rubenshubnerjunior/VFO_SI5351_Nano_4X/README.md

### Este projeto visa:
#### Construir um gerador de frequência em quadratura ( 0º e 90° ) na faixa de 500 Khz a 30 Mhz.
#### Construir um circuito QSD para demodular sinais de RF modulados em AM, FM e SSB.
#### Construir um circuito QSE para modular um sinal de RF ( em pesquisa...).
#### Diagrama simplificado:
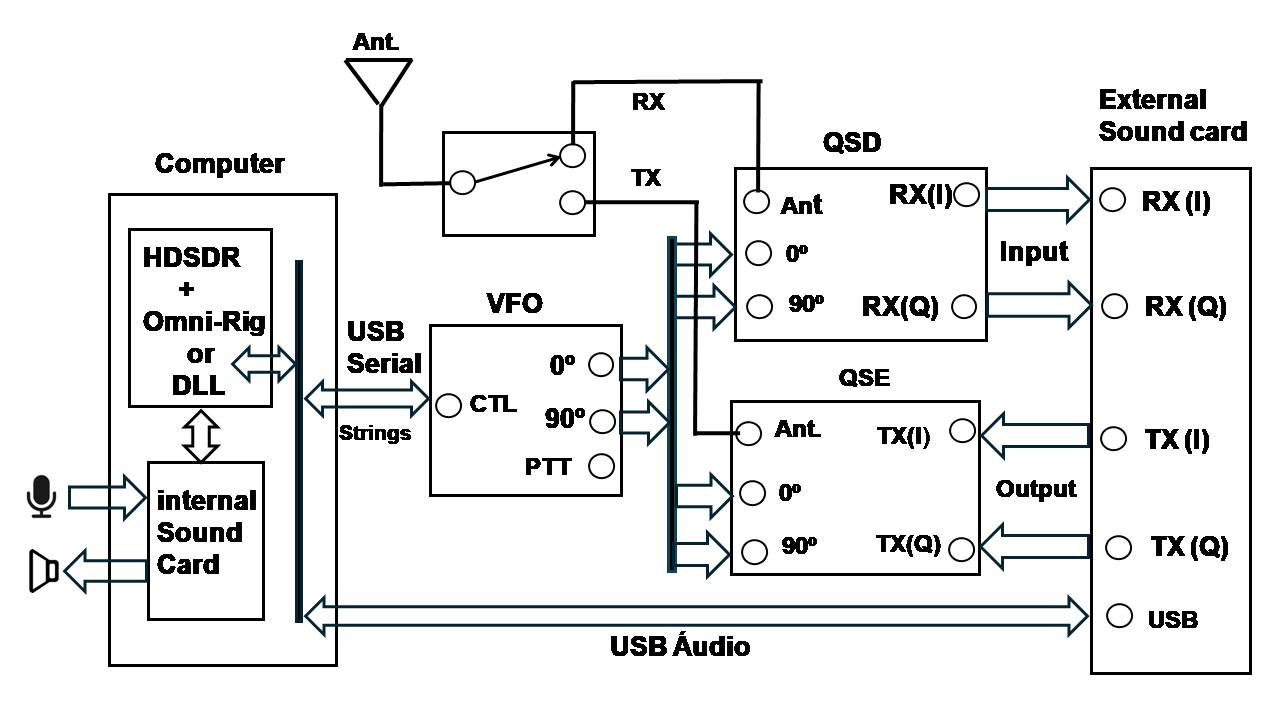
[picture p1: Diagramas/diagrama2.jpg]
- 
#### O Hardware VFO fornece sinais em quadratura na frequência de recepção/transmissão desejada (controlado por um arduino nano).
#### O Hardware QSD recebe o RF da antena e converte em sinais I & Q que vão para o computador através da placa de som.
#### O Hardware QSE recebe os sinais I & Q do computador através da placa de som converte para RF e envia para a antena.
#### Os sinais I & Q estão dentro da faixa da placa de som ( normalmente 48 Khz mas placas de 192 Khz são melhores ).
#### QSD--> Quadrature Signal Decoder.
#### QSE--> Quadrature signal Encoder.
#### No final de cada etapa ( VFO, QSD e futuramente o QSE )  tem  vídeos de teste.
# VFO
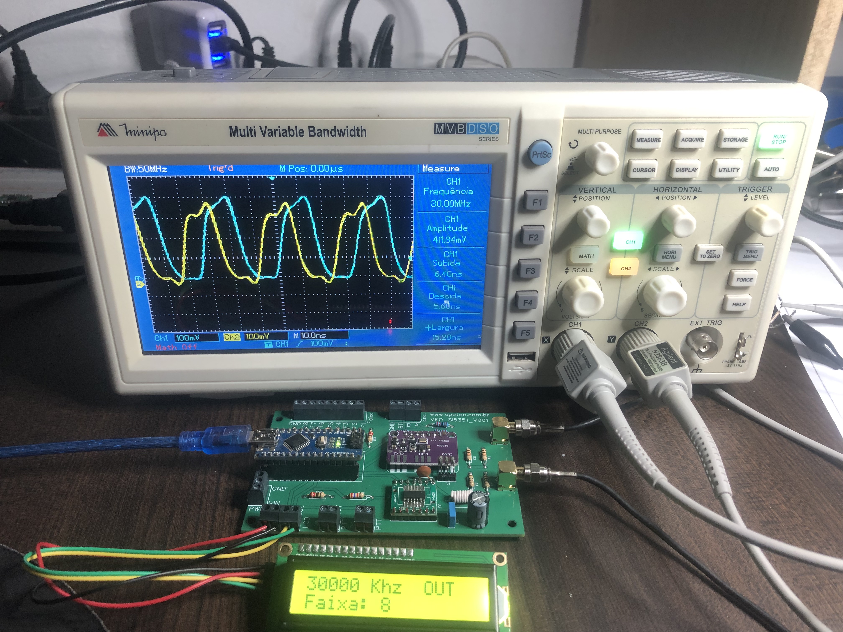
[picture p2: Fotos/VFO_5351_4X.jpg]
- 
#### Basicamente temos o módulo SI 5351 que é comandado através do Arduino Nano usando o protocolo I2C.
#### A saída do módulo SI 5351 deve estar em uma frequência de 4 vezes a frequência desejada para que o divisor por 4 feito pelo flip flop 74AC74 gere a quadratura.
#### O software HDSDR junto com o Omni-Rig usando a configuração TS-480 controla a frequencia e o PTT deste VFO.
#### Foi codificado em python um programa testeVFO.exe para testar o programa do arduino e está na pasta testeVFO o script e o executável.
#### O arquivo testeVFO.exe envia pela porta serial as Strings semelhante as geradas pelo HDSDR.
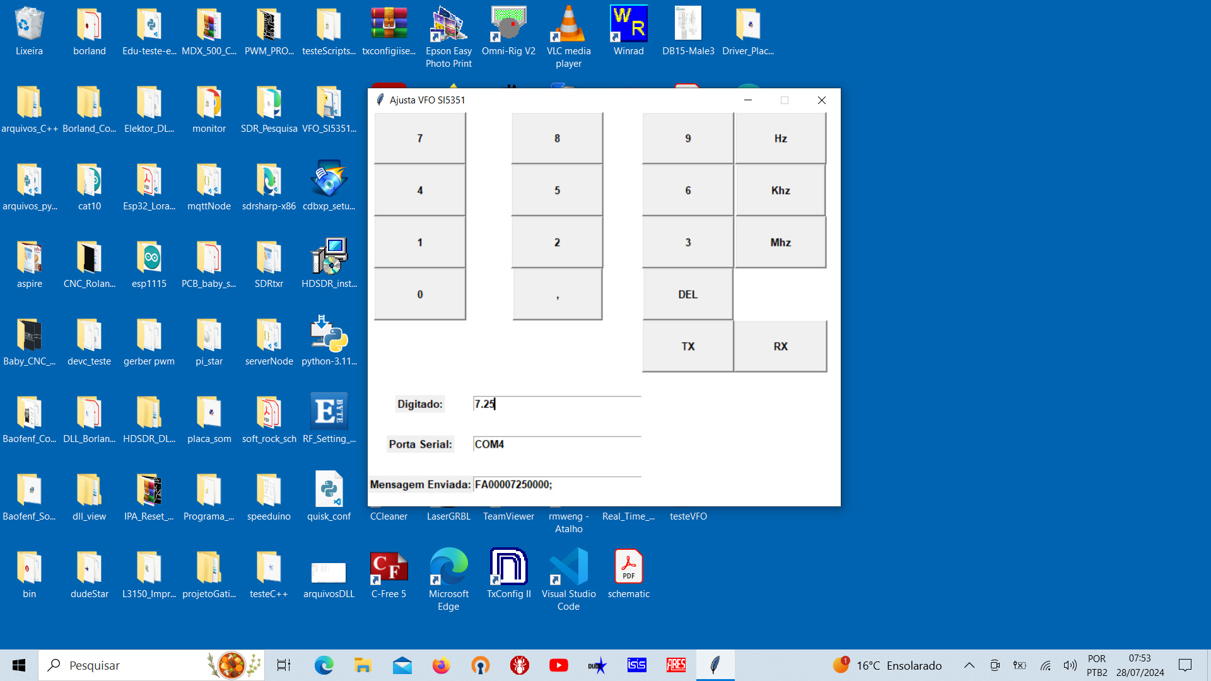
[picture p3: Fotos/testeVFO.jpg]
- 
#### O Arduino nano recebe os comandos através da porta serial (Terminal Serial ou do HDSDR/Omni-Rig) veja abaixo:
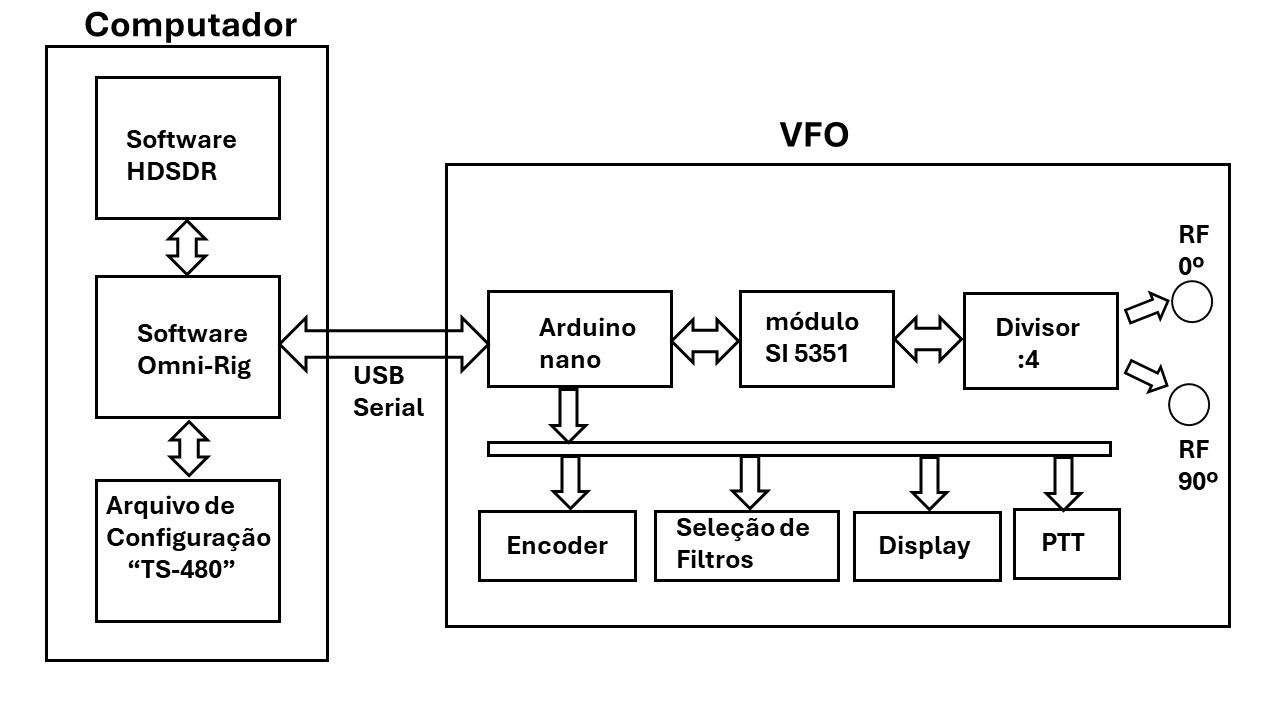
[picture p4: Diagramas/diagrama_vfo.jpg]
- 
#### A Frequência (3 - 30 Mhz) e o Step ( 1Khz, 10Khz, 100Khz e 1000Khz) também pode ser ajustada através do Encoder em KHZ.
#### O PTT também pode ser acionado via contato diretamente na placa.
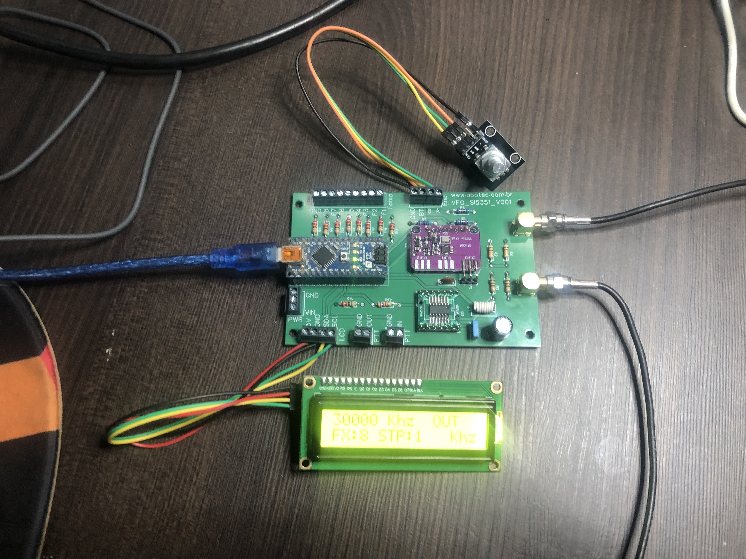
[picture p5: Fotos/VFO_Encoder.jpg]
- 
#### A faixa de 3 a 30 Mhz pode ser dividida em 08 subfaixas e coloca em nivel HI ou Low as saidas do conector para usar nas comutações dos filtros (vide esquema).
#### O display mostra a frequência de saída bem como a faixa e o Step ajustado.
#### O código fonte do arduino (pasta cat11) está bem comentado (CAT= Computer Aided Transceiver ou Computer Aided Tuning).
#### Durante o processo de programação para fazer o Debug foi utilizado outro arduino Nano como escravo I2C pois a porta serial do arduino usado no VFO fica ocupada recebendo e enviando dados para o computador:
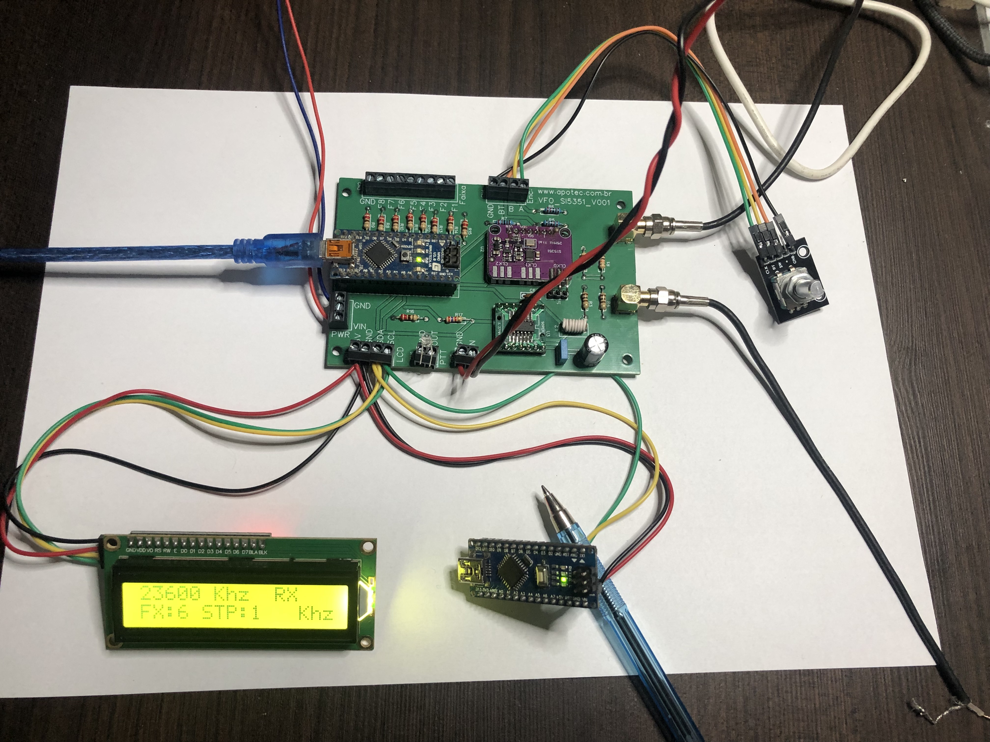
[picture p6: Fotos/nano_debug.jpg]
-  
#### Foi usado o codigo monitor_I2C em outro Arduino Nano Escravo para fazer o Debug pela porta serial (I2C -> Serial), acrescidas linhas de codigo no arduino do cat11.ino para enviar mensagens ao escravo isto somente para Debug depois as linhas foram comentadas e o arduino Nano escravo retirado do circuito.

#### Alguns comandos enviados e recebidos via porta Serial:
- FA00006000000; // HDSDR ajusta o VFO para 6 Mhz
- FA00030000000;  // HDSDR ajusta o VFO para 30 Mhz
- TX1;  // HDSDR envia informação para entrar no modo TX
- RX;   // HDSDR  envia informação para entrar no modo RX
- FA;   // HDSDR pede informação da frequência para o VFO
- FA00007349999; // VFO informa a frequencia para o HDSDR
#### Os comandos do HDSDR para o VFO e do VFO para o HDSDR sempre tem o (;) no final
#### O HDSDR pede várias informações ao VFO e não implementei todas por isto fica a mensagem de Rig não responde.
####  Tela de Configuração do Omni-Rig (A porta do Arduino Nano pode ser localizada no Gerenciador de Dispositivos):
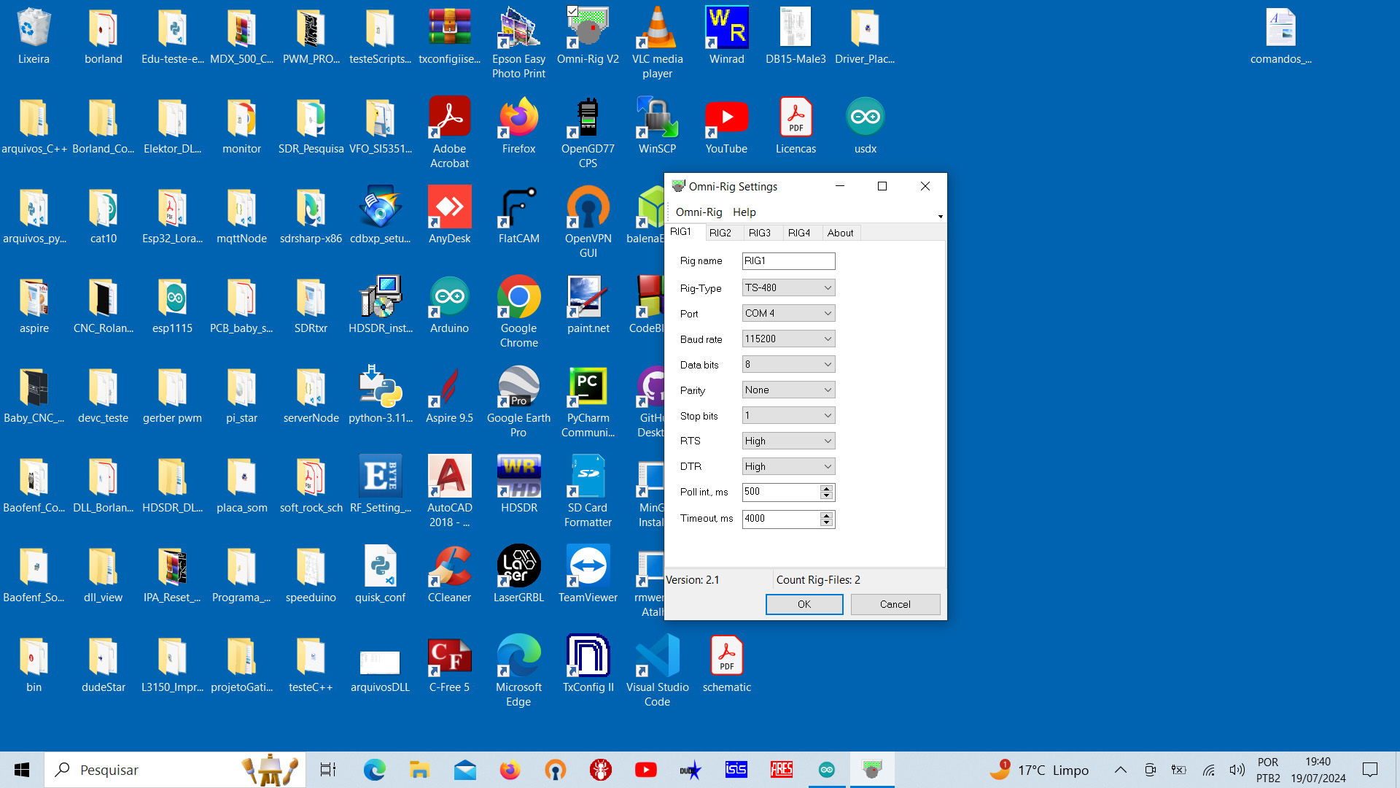
[picture p7: Fotos/Omnia_Config.jpg]
- 
#### No HDSDR no menu Options:
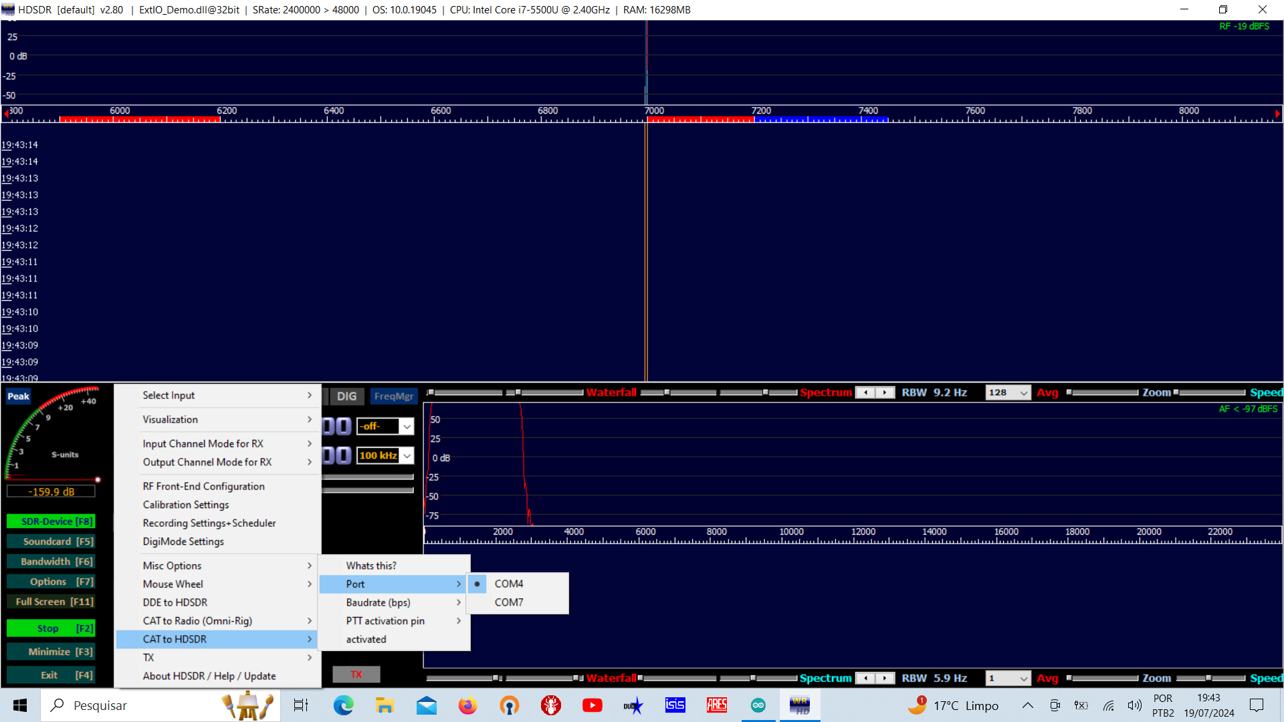
[picture p8: Fotos/HDSDR_01.jpg]
- 
  #### Não esquecer de ativar.
  #### No HDSDR no menu Options:
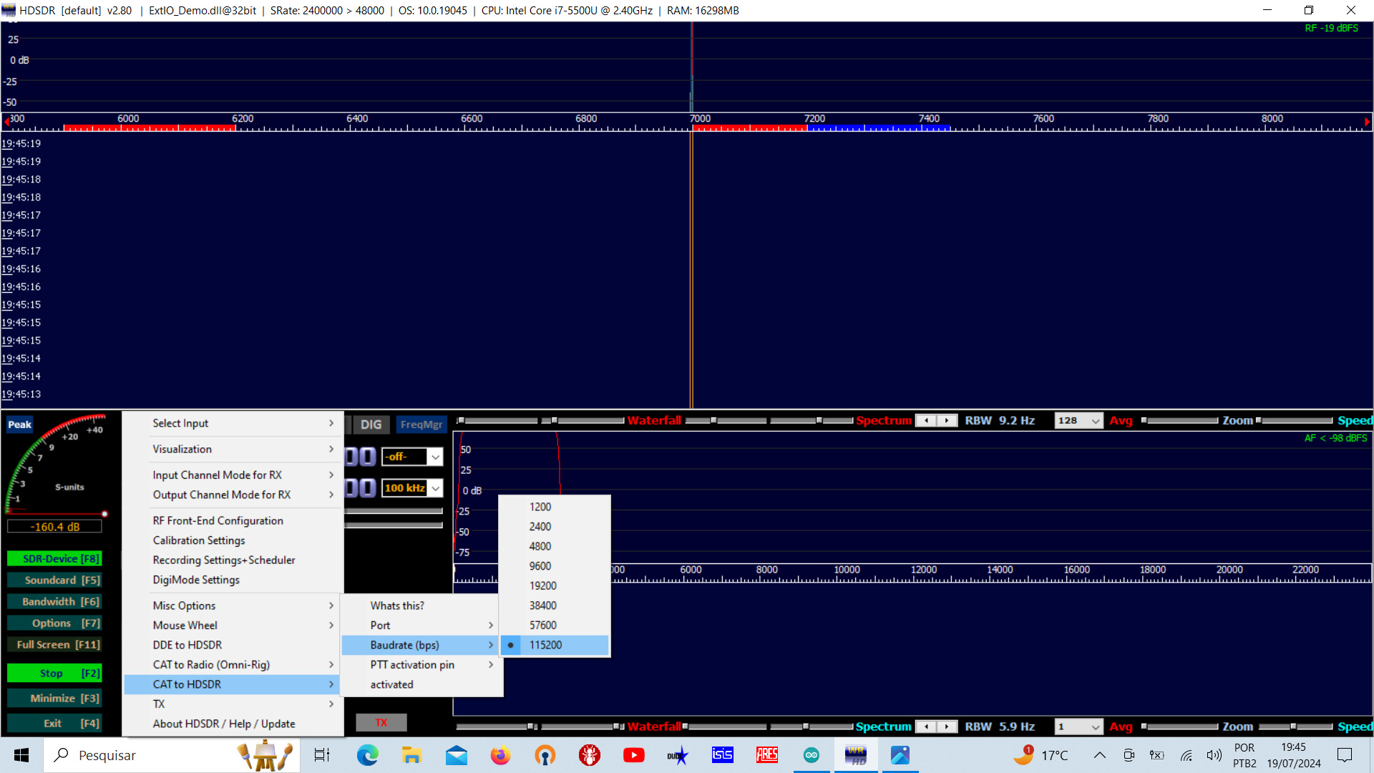
[picture p9: Fotos/HDSDR_02.jpg]
- 
  #### No HDSDR no menu Options:
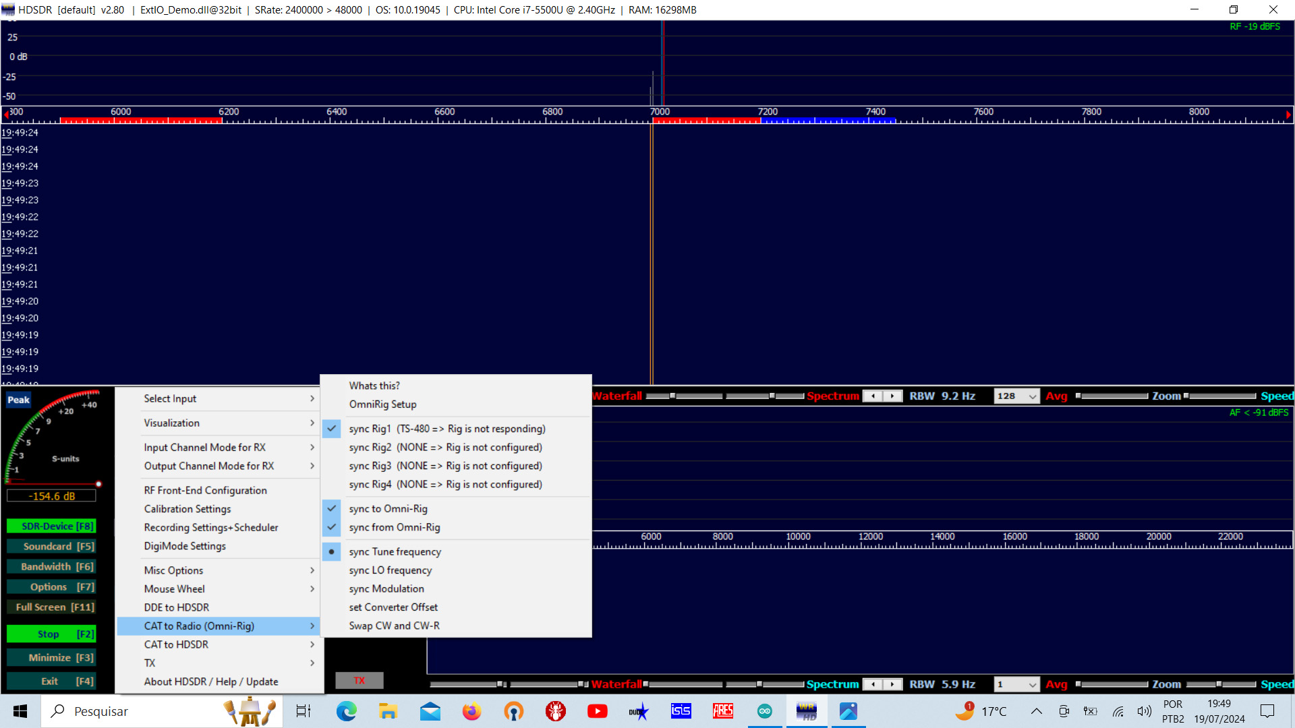
[picture p10: Fotos/HDSDR_03.jpg]
- 
  #### No HDSDR no menu Options:
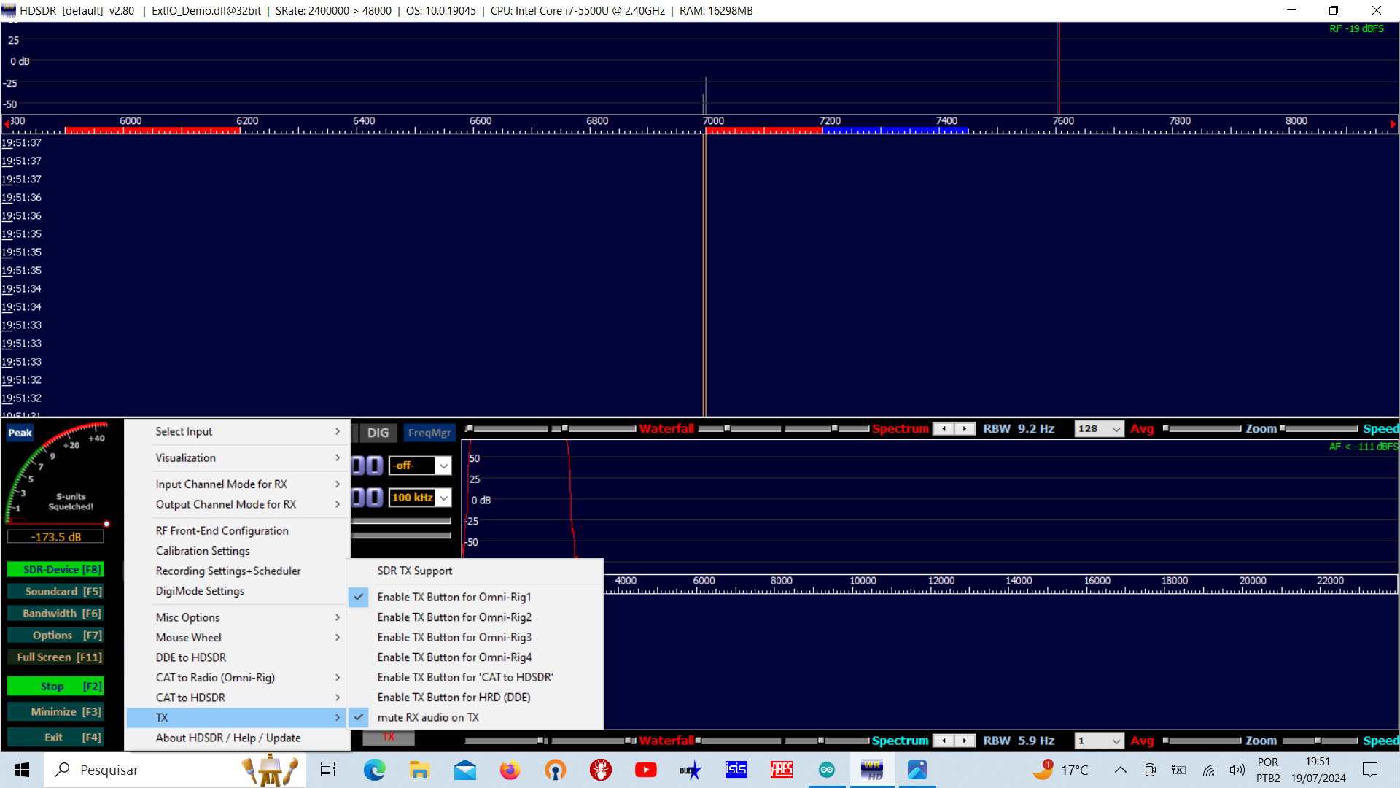
[picture p11: Fotos/HDSDR_04.jpg]
- 
#### O HDSDR tem muitas configurações mas estas são suficientes para acionar o VFO, outras deverão ser feitas quando for receber ou gerar os sinais I e Q da placa de som.
#### Testes do VFO:
- https://www.youtube.com/watch?v=RT_Q52dTLLc&t=126s
# QSD 
#### Hardware para executar a demodulação.
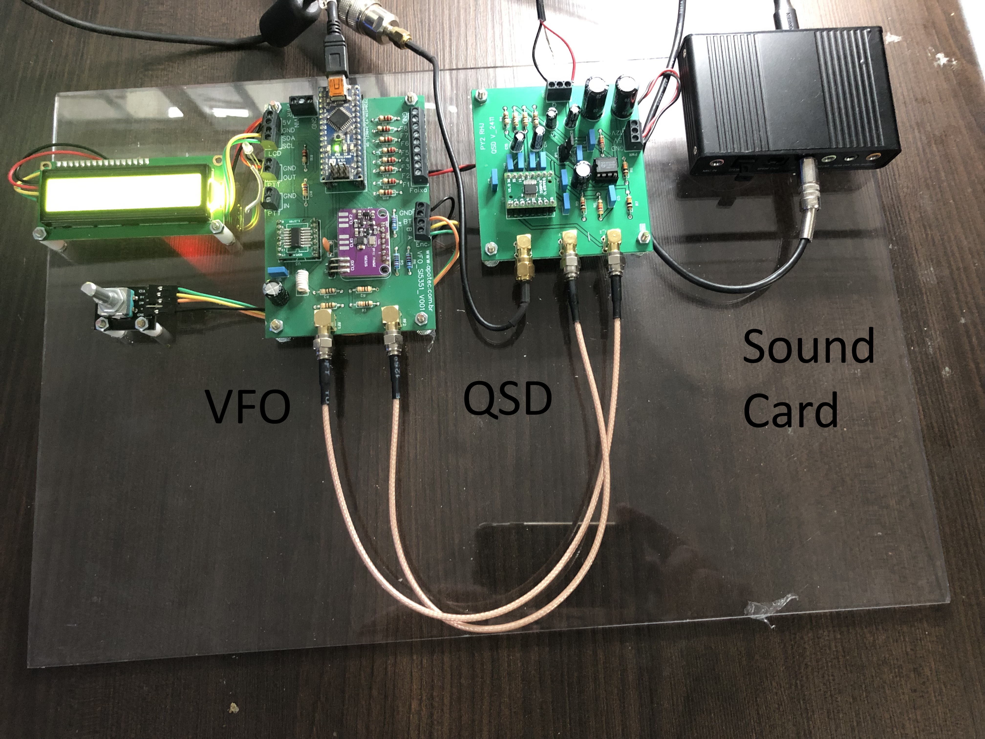
[picture p12: Fotos/QSD_Editado.jpg]
- 
  #### No circuito do QSD para demoduladar o sinal de RF foi usado o mixer Tayloe.
  #### O Esquema encontra-se na pasta esquemas.
  
  #### Explicação do QSD:
 - https://www.youtube.com/watch?v=EsmPDjM7D9w
  #### Testes com o TinySA:
   - https://www.youtube.com/watch?v=oZrHM2pHxTM
  #### Recepção SSB:
   - https://www.youtube.com/watch?v=dkrUPmy8qsQ
  #### Recepção AM:
  - https://www.youtube.com/watch?v=Rc6pbZAcLpk
# QSE
#### Hardware para executar a Modulação.
#### Para usar o HDSDR no modo transmissão foi preciso modificar uma DLL veja o vídeo:
- https://www.youtube.com/watch?v=wrtzsCQlcew
#### Seleção das placas de som para (QSD RX)-->HDSDR /  HDSDR-->(QSE TX) e Mic.-->HDSDR exemplo:
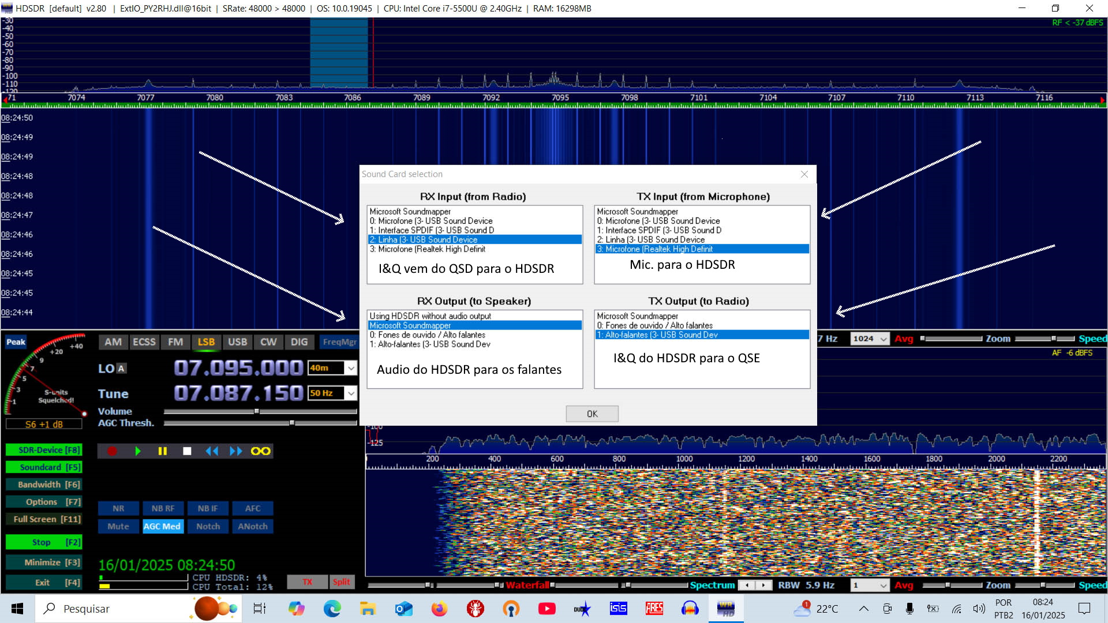
[picture p13: Fotos/HDSDR_Card.jpg]
- 
  
#### O circuito do QSE ainda está em pesquisa...

#### Este documento trata-se de anotações de pesquisa sobre o SDR e por não ser uma Verdade Absoluta correções e melhorias sempre são bem vindas.

### 73's  PY2 RHJ     ID DMR:7245251
