rubenshubnerjunior/VFO_SI5351_Nano_4X/Diagramas/diagrama_vfo.pptx

Computador

Software
HDSDR

Arquivo de
Configuração
“TS-480”

VFO

RF
0º

Software
Omni-Rig

Arduino
nano

módulo
SI 5351

Divisor
:4

USB
Serial

RF
90º

Encoder

Seleção de
Filtros

Display

PTT
