rubenshubnerjunior/VFO_SI5351_Nano_4X/Diagramas/diagrama2.pptx

Ant.

RX

External
Sound card

RX (I)

RX (Q)

TX (Q)

Computer

HDSDR
+
Omni-Rig
or
DLL

internal
Sound
Card

TX

QSD

RX(I)

Input

Ant

0º

VFO

90º

RX(Q)

USB
Serial

Strings

0º

QSE

CTL

90º

Ant.

TX(I)

Output

TX (I)

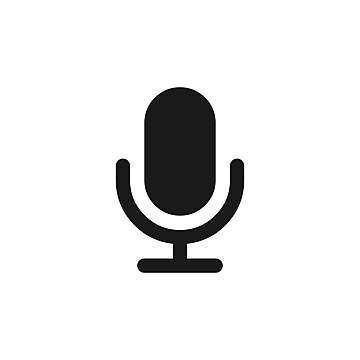
[picture p16: figure]

PTT

0º

90º

TX(Q)

USB Áudio

USB
