rubenshubnerjunior/VFO_SI5351_Nano_4X/Fotos/imagem_1.jpg

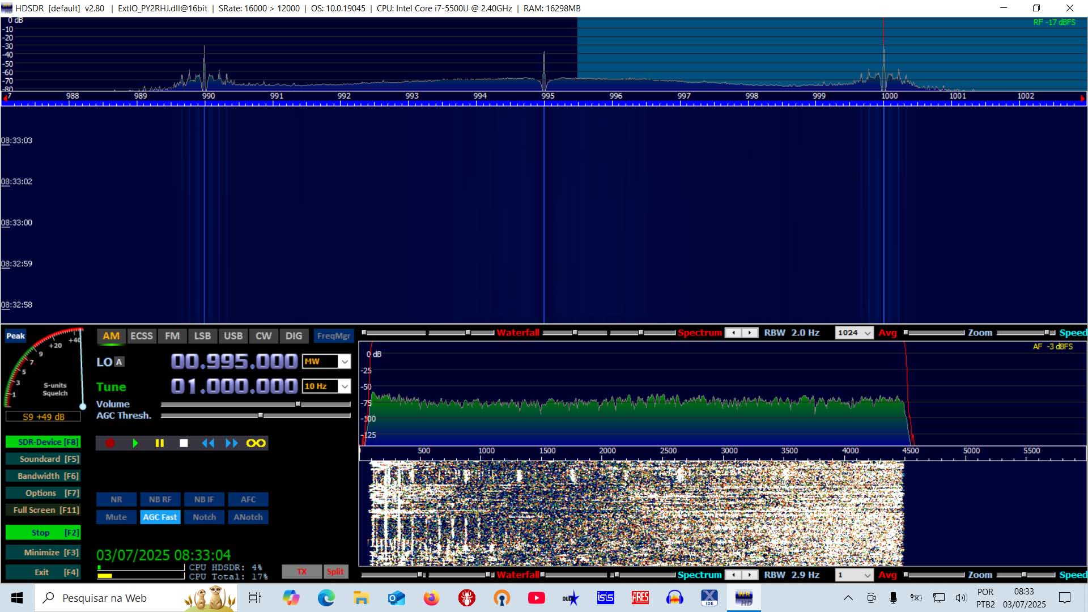
Fotos/imagem_1.jpg
