rubenshubnerjunior/VFO_SI5351_Nano_4X/Fotos/imagem_2.jpg

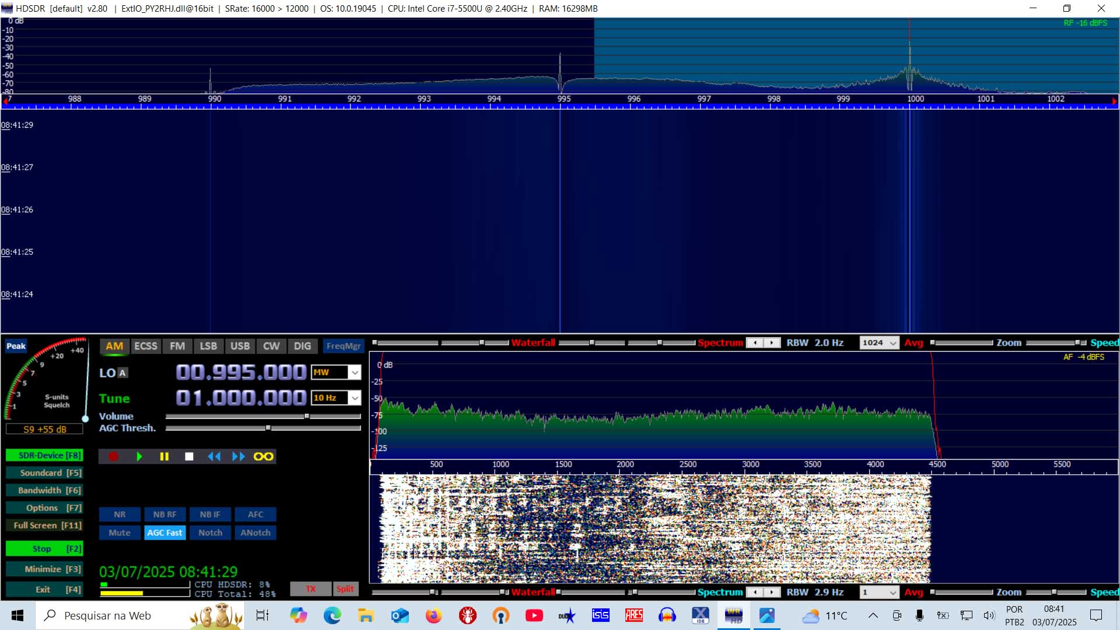
Fotos/imagem_2.jpg
