rubenshubnerjunior/VFO_SI5351_Nano_4X/SDR_Graficos/mixer_1.png

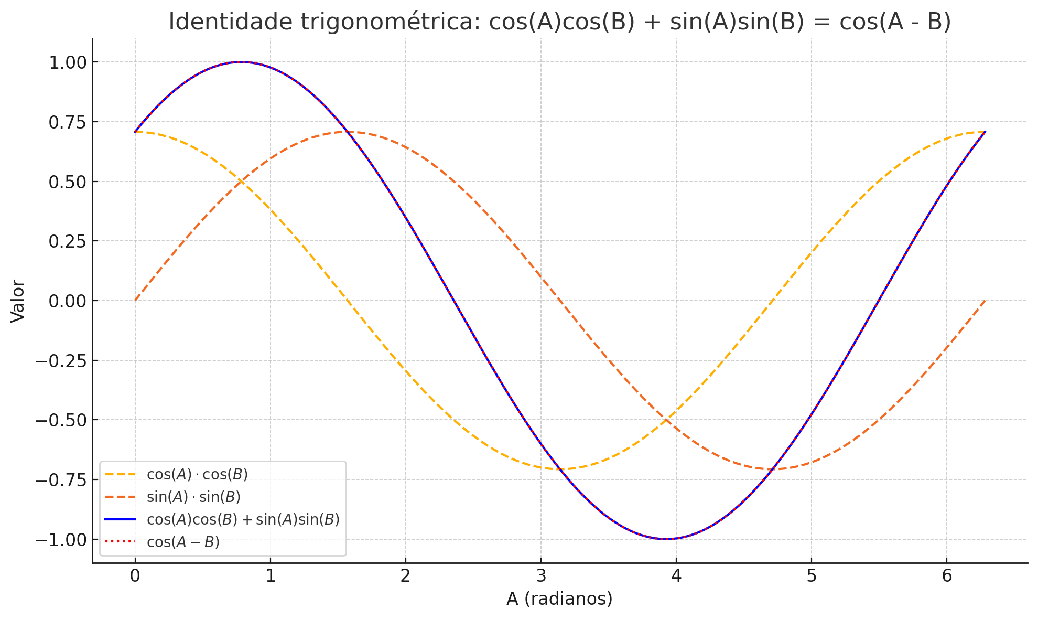
SDR_Graficos/mixer_1.png
