rubenshubnerjunior/VFO_SI5351_Nano_4X/SDR_Graficos/produtos_trigonometria.png

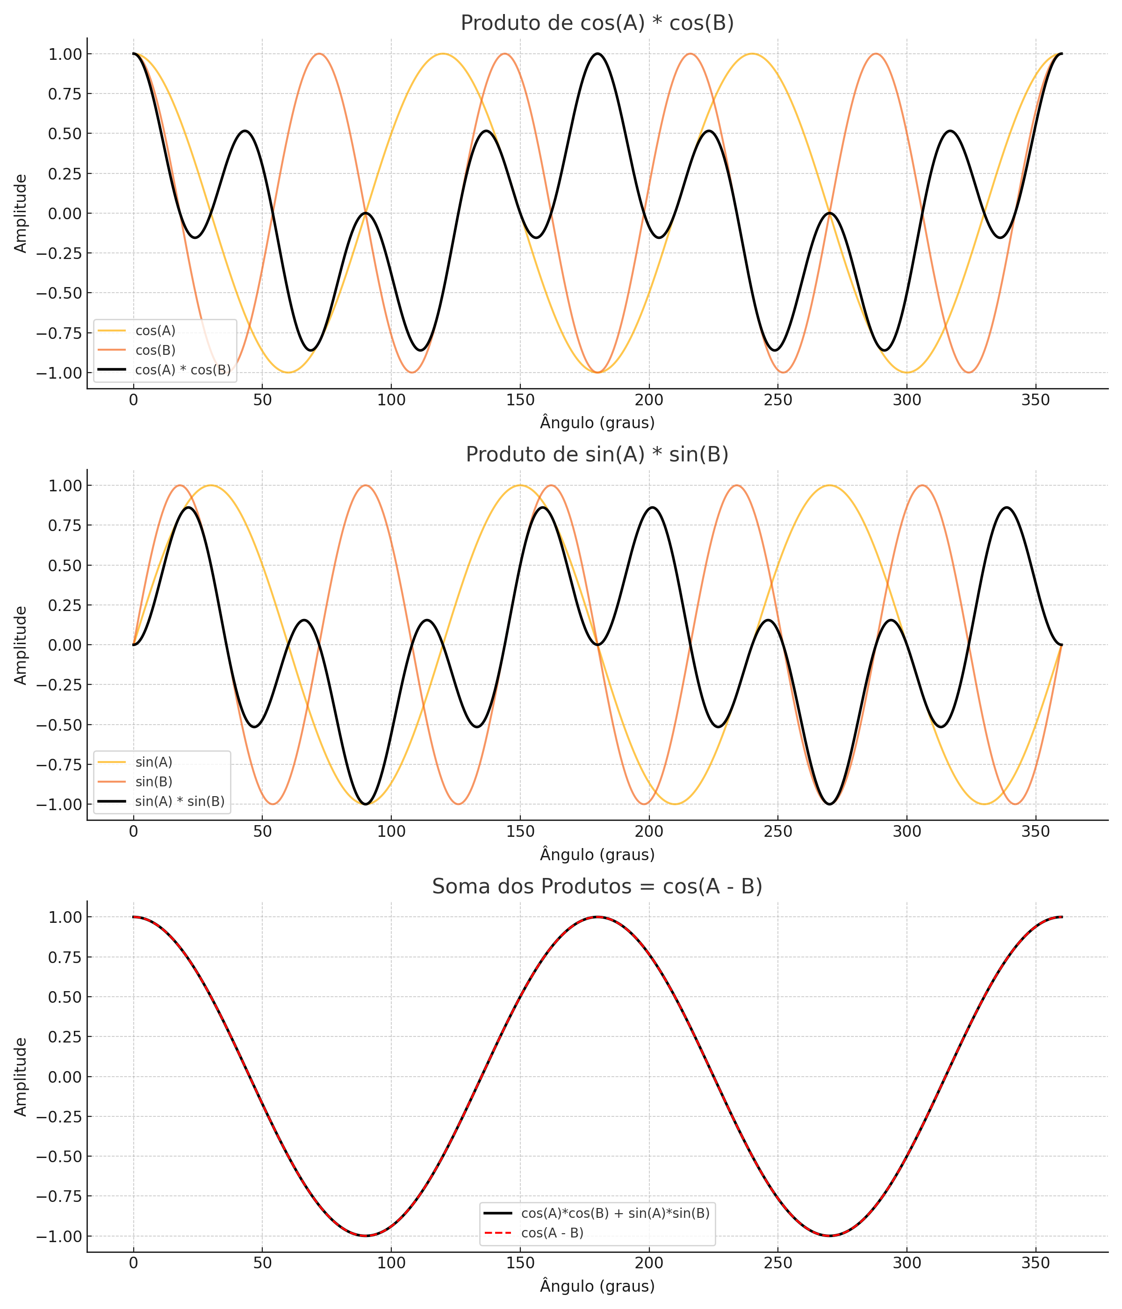
SDR_Graficos/produtos_trigonometria.png
