rubenshubnerjunior/VFO_SI5351_Nano_4X/(threads)

Thread 2 (2024-12-17):

VFO x 4 and 0° and 90° and flip_flop

iw2fvo, 2024-12-17:
Good day Sir,
I would like to pose those few question to better understand the system operation:
1> If the 5351 generates both I and Q signals at 90° apart, what is the reason of using the flip/flop 7474 ?
2> does the rotary encoder command the frequency of the HSDR  and the HDSDR command the fequency of the  5351 ?
3> what is the max operating frequency ? ( 3 to 30 Mhz or 3 to 50 Mhz ?).
thanks for helping .
regards
Ambro

rubenshubnerjunior, 2024-12-17:
Good afternoon
Actually, I did two tests with the SI5352.
In the post: https://github.com/rubenshubnerjunior/VFO_SI5351_Serial, the
quadrature was generated using software and in the post:
https://github.com/rubenshubnerjunior/VFO_SI5351_Nano_4X, the flip flop was
used to generate the quadrature.
In the case of using the flip flop, the frequency should be 4X the intended
one.
In the case of using the flip flop, I found the response better and tested
it at a frequency close to 50 MHz. Although I saw the signals, I cannot say
anything about the amplitude because my oscilloscope has limitations.
I've seen some posts where the Raspberry PI Pico can be used to obtain the
quadrature through the PIO, but I don't know what the behavior is above 10
MHz.
Now I'm doing tests with the QSD and using the quadrature generated in the
flipflop, it worked well.
Cheers

Em ter., 17 de dez. de 2024 às 07:42, iw2fvo ***@***.***>
escreveu:

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

iw2fvo, 2024-12-17:
Thanks for the reply,Just to summarize: what do you suggest: software quadrature or flip flop quadrature  ?Thanks again for helping .regards,iw2fvo,  Ambrogio

    On Tuesday, December 17, 2024 at 04:51:50 PM GMT+1, rubenshubnerjunior ***@***.***> wrote:

Good afternoon
Actually, I did two tests with the SI5352.
In the post: https://github.com/rubenshubnerjunior/VFO_SI5351_Serial, the
quadrature was generated using software and in the post:
https://github.com/rubenshubnerjunior/VFO_SI5351_Nano_4X, the flip flop was
used to generate the quadrature.
In the case of using the flip flop, the frequency should be 4X the intended
one.
In the case of using the flip flop, I found the response better and tested
it at a frequency close to 50 MHz. Although I saw the signals, I cannot say
anything about the amplitude because my oscilloscope has limitations.
I've seen some posts where the Raspberry PI Pico can be used to obtain the
quadrature through the PIO, but I don't know what the behavior is above 10
MHz.
Now I'm doing tests with the QSD and using the quadrature generated in the
flipflop, it worked well.
Cheers

Em ter., 17 de dez. de 2024 às 07:42, iw2fvo ***@***.***>
escreveu:

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

—
Reply to this email directly, view it on GitHub, or unsubscribe.
You are receiving this because you authored the thread.Message ID: ***@***.***>

rubenshubnerjunior, 2024-12-17:
Solving directly with software on the SI module is more economical and
takes up less space.
In the case of using software, some PLL calculations are made for each
desired frequency.
I prefer to use the flip flop because the solution is given by hardware and
covers a large frequency range and maintains quadrature.
But everything depends on future uses. There are projects like the usdx
that use the 03 outputs of the module. I believe this is due to
transmission.
I am still researching and everything mentioned is still the result of some
observations made recently.
73

Em ter., 17 de dez. de 2024 às 13:56, iw2fvo ***@***.***>
escreveu:

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
