rubenshubnerjunior/VFO_SI5351_Nano_4X/Esquemas/QSD_2112_PCB.pdf

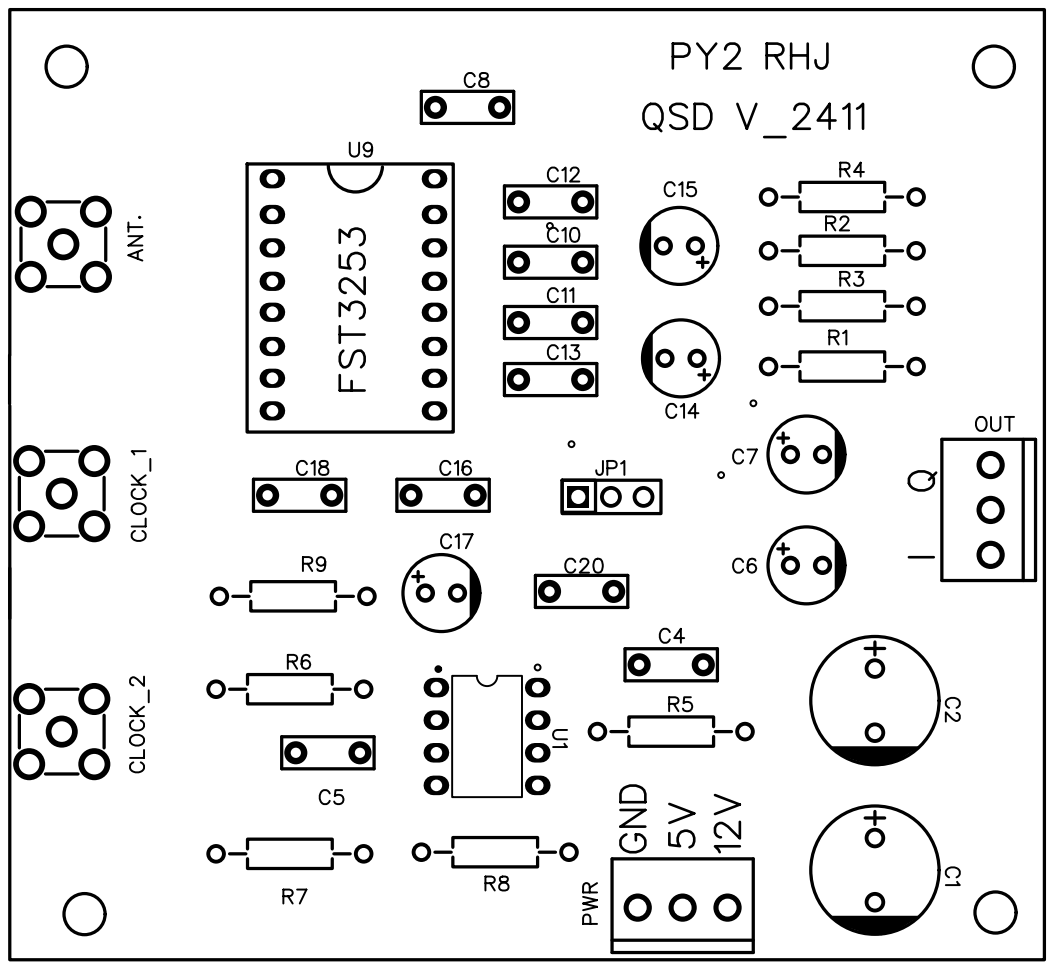
[picture p25: page 1]
