rubenshubnerjunior/VFO_SI5351_Nano_4X/Diagramas/diagrama2.pdf

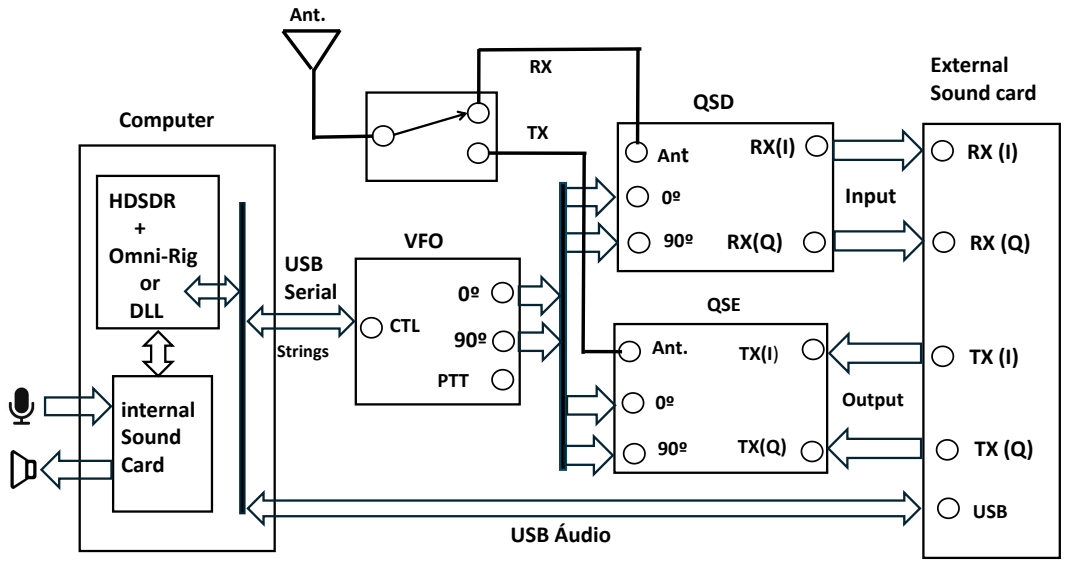
[picture p26: page 1]
USB Serial; Computer; VFO; QSD; HDSDR + Omni-Rig or DLL; External Sound card; USB Áudio; Input; Ant.; Ant; internal Sound Card; CTL; PTT; QSE; Output; USB; Strings
