rubenshubnerjunior/VFO_SI5351_Nano_4X/Esquemas/QSD_2112.pdf

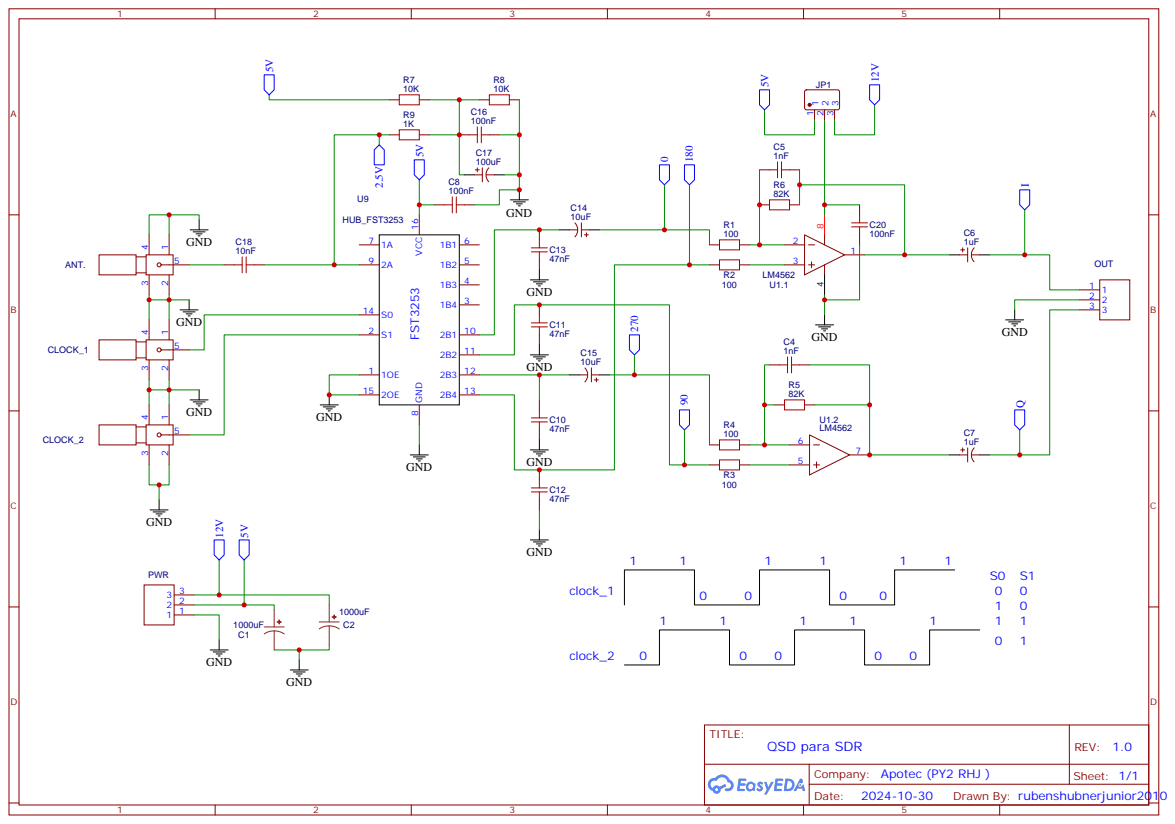
[picture p27: page 1]
