rubenshubnerjunior/VFO_SI5351_Nano_4X/Esquemas/PCB_PCB_VFO_Nano_SI5351_A_2024-07-08.pdf

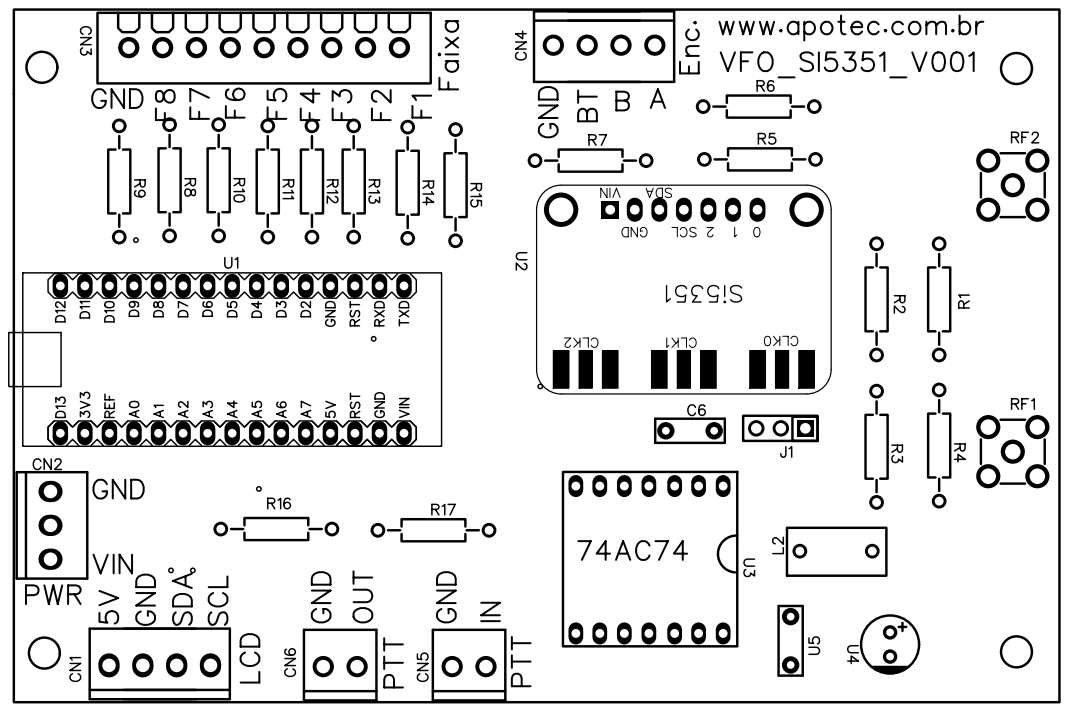
[picture p28: page 1]
