rubenshubnerjunior/VFO_SI5351_Nano_4X/(commit log)

2024-07-09 mudança de nome
    mudado o nome do arquivo do arduino
2024-07-09 Update cat11.ino
    Inserido o encoder
2024-07-09 Update cat11.ino
    Tratamento de bounce do encoder
2024-07-09 Update cat11.ino
    melhoria do bouce do encoder
2024-07-11 inserido biblioteca
    biblioteca usada para o SI5352
2024-07-11 Update cat11.ino
    Melhorias no tempo de resposta do LCD
2024-07-19 Omnirig TS 480
    Alterado para funcionar com o Omni-rig usando a configuração do TS480
2024-07-19 fotos
    adicionado foto do arduino nano como debug
2024-07-19 fotos
    Fotos de configurações
2024-07-27 teste vfo
    Adicionado código em python para testar o VFO
2024-07-28 mudança de pasta
    colocado o script python e o executavel na mesma pasta
2024-07-28 Update cat11.ino
    Comentado linhas de código referente ao debug com Arduino escravo I2C
2024-07-28 Create testeVFO.jpg
    Inserido foto do aplicativo para teste do VFO
2024-12-21 Create Schematic_iqAmplifier_2024-12-20.pdf
    Adicionado esquema do qsd
2024-12-21 mudança de nome
    Renomeado o esquema do QSD
2025-01-08 Pasta DLL_HDSDR
    Inserido um arquivo de DLL para usar com o HDSDR
2025-01-08 mudança de extensão
    passou arquivo rtf para txt
2025-01-10 Inserido pcb
    Top silk do pcb do QSD
2025-01-16 insere imagem
    imagem das placas de som
2025-01-25 alteracao
    Aterado a faixa de frequencia e liberado a monitoração I2C
2025-01-25 update monitoração
    Ajustado ver Resposta da requisição de frequencia
